krunaldesai/jubilant-waffle/README.md

# jubilant-waffle
HW/SW for PAC-USWHS002-WF-2 replacement based on m5stack AtomS3 mini and ESPhome
