krunaldesai/jubilant-waffle/hw/Carrier_Board/Carrier_Board.kicad_pcb

## KiCad design hw/Carrier_Board/Carrier_Board.kicad_pcb (2025-02-16)

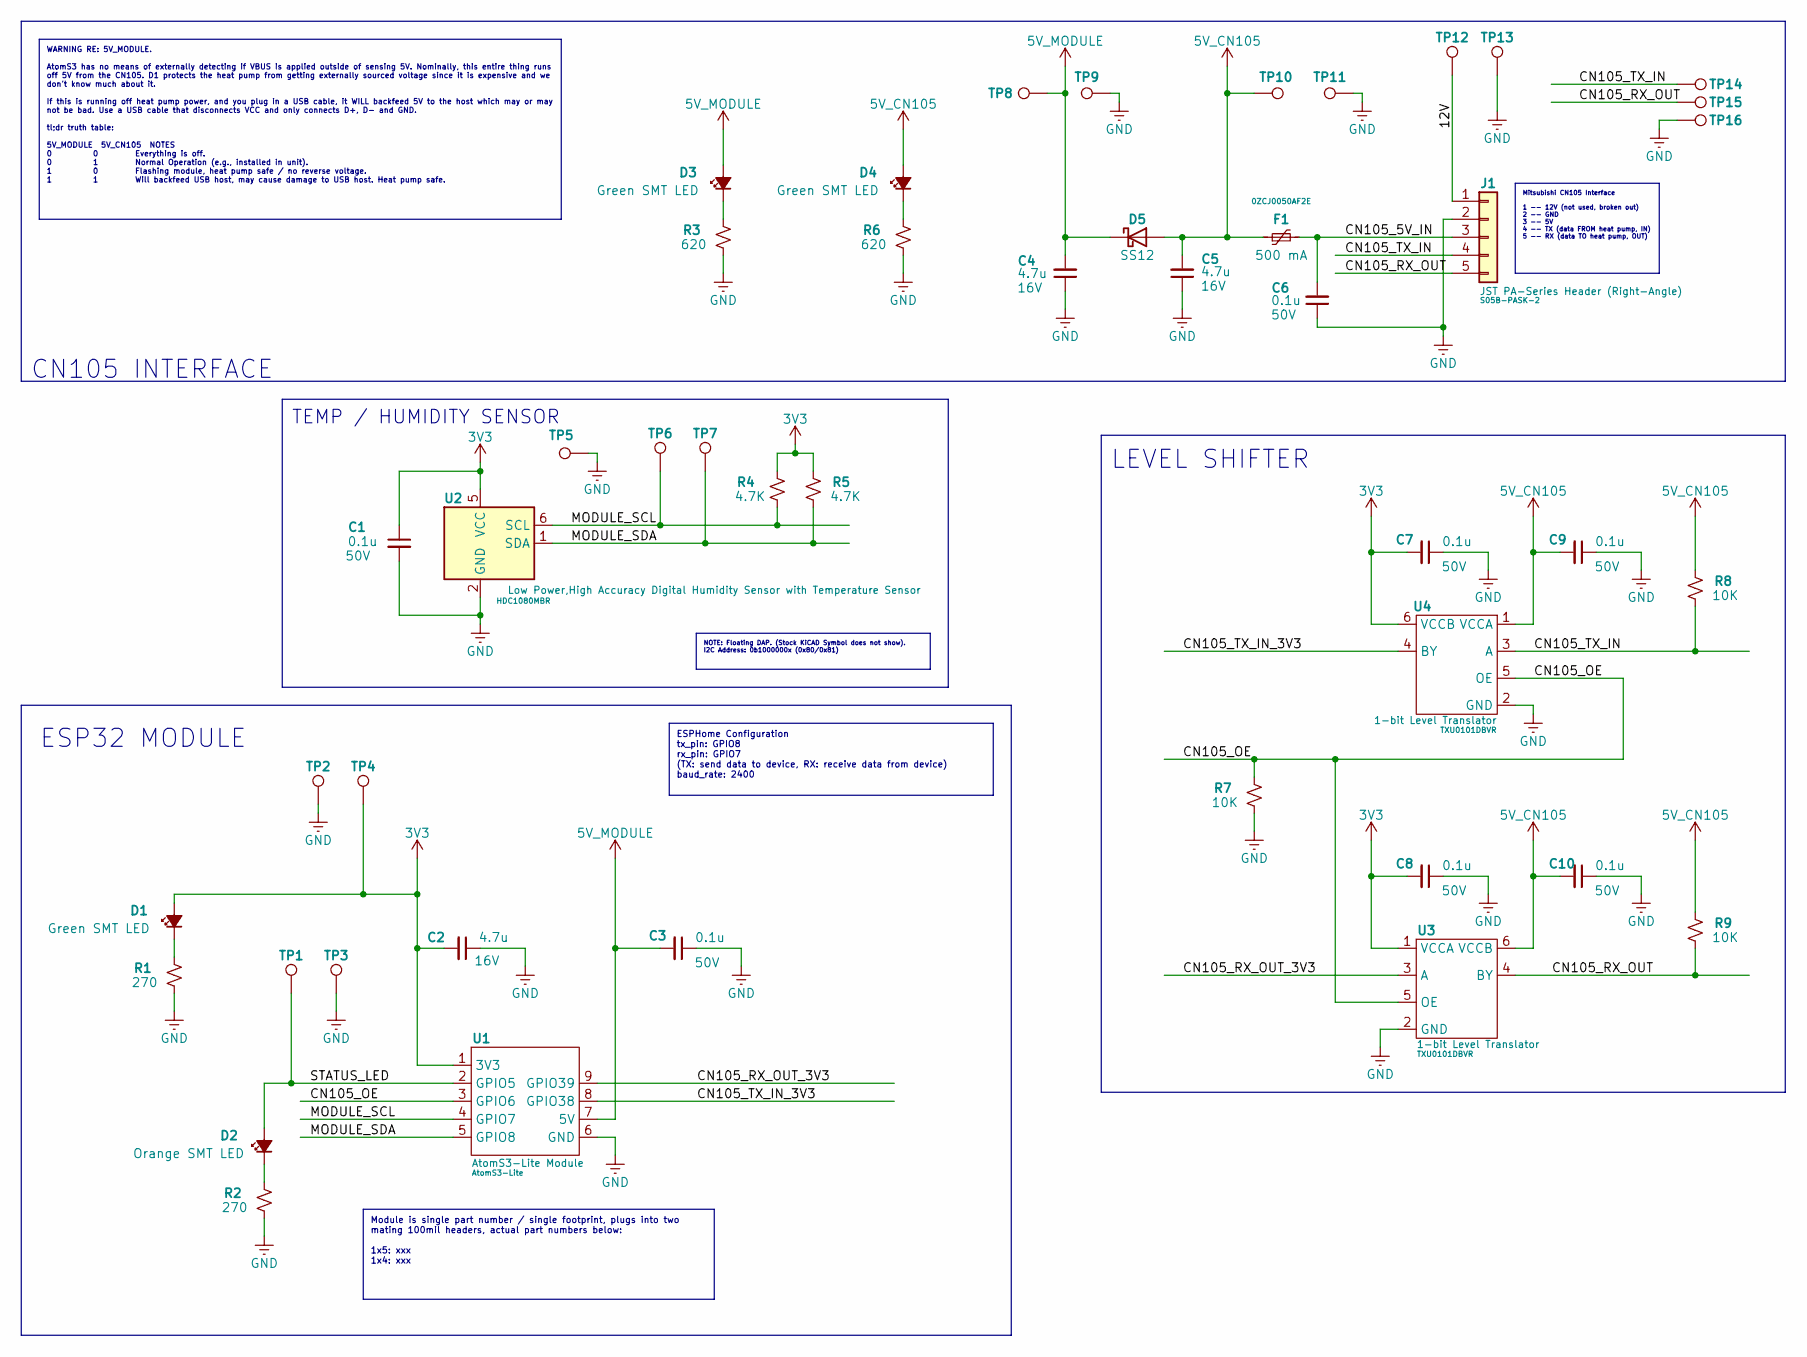
[picture p1: schematic Carrier_Board.kicad_sch, CN105 Interface Board]

Parts:
C1, C3, C6, C7, C8, C9, C10: 0.1u; C_0603_1608Metric_Pad1.08x0.95mm_HandSolder; Voltage 50V; ManufacturerPartNumber C0603C104K5RAC7411
C2, C4, C5: 4.7u; C_0805_2012Metric_Pad1.18x1.45mm_HandSolder; Voltage 16V; ManufacturerPartNumber GRM21BR71C475KE51L
D1, D3, D4: LED_Small_Filled; LED_0603_1608Metric_Pad1.05x0.95mm_HandSolder; ManufacturerPartNumber LTST-C190GKT
D2: LED_Small_Filled; LED_0603_1608Metric_Pad1.05x0.95mm_HandSolder; ManufacturerPartNumber LTST-C190AKT
D5: SS12; D_SMA; ManufacturerPartNumber SS12
F1: 500 mA; Fuse_1206_3216Metric_Pad1.42x1.75mm_HandSolder; ManufacturerPartNumber 0ZCJ0050AF2E
J1: JST PA-Series Header (Right-Angle); JST_PA_S05B; ManufacturerPartNumber S05B-PASK-2
R1, R2: 270; R_0603_1608Metric_Pad0.98x0.95mm_HandSolder; ManufacturerPartNumber ERJ-3GEYJ271V
R3, R6: 620; R_0603_1608Metric_Pad0.98x0.95mm_HandSolder; ManufacturerPartNumber ERJ-3GEYJ621V
R4, R5: 4.7K; R_0603_1608Metric_Pad0.98x0.95mm_HandSolder; ManufacturerPartNumber ERJ-3GEYJ472V
R7, R8, R9: 10K; R_0603_1608Metric_Pad0.98x0.95mm_HandSolder; ManufacturerPartNumber ERJ-3GEYJ103V
TP1, TP2, TP3, TP4, TP5, TP6, TP7, TP8, TP9, TP10, TP11, TP12, TP13, TP14, TP15, TP16: TestPoint; TestPoint_Keystone_5000-5004_Miniature
U1: Atom_S3-Lite; ManufacturerPartNumber AtomS3-Lite
U2: HDC1080; Texas_PWSON-N6; ManufacturerPartNumber HDC1080MBR
U3, U4: SOT-23-6_Handsoldering; ManufacturerPartNumber TXU0101DBVR

Connections:
3V3: C1.1, C2.2, C7.2, C8.2, D1.2 (A), R4.1, R5.1, TP4.1, U1.1 (3V3), U2.5 (VCC), U3.1 (VCCA), U4.6 (VCCB)
5V_CN105: C5.2, C9.2, C10.2, D4.2 (A), D5.2 (A), F1.1, R8.1, R9.1, TP10.1, U3.6 (VCCB), U4.1 (VCCA)
5V_MODULE: C3.2, C4.2, D3.2 (A), D5.1 (K), TP8.1, U1.7 (5V)
/12V: J1.1, TP12.1
/CN105_5V_IN: C6.2, F1.2, J1.3
/CN105_OE: R7.1, U1.3 (GPIO6), U3.5 (OE), U4.5 (OE)
/CN105_RX_OUT: J1.5, R9.2, TP15.1, U3.4 (BY)
/CN105_RX_OUT_3V3: U1.9 (GPIO39), U3.3 (A)
/CN105_TX_IN: J1.4, R8.2, TP14.1, U4.3 (A)
/CN105_TX_IN_3V3: U1.8 (GPIO38), U4.4 (BY)
/MODULE_SCL: R4.2, TP6.1, U1.4 (GPIO7), U2.6 (SCL)
/MODULE_SDA: R5.2, TP7.1, U1.5 (GPIO8), U2.1 (SDA)
/STATUS_LED: D2.2 (A), TP1.1, U1.2 (GPIO5)
GND: C1.2, C2.1, C3.1, C4.1, C5.1, C6.1, C7.1, C8.1, C9.1, C10.1, J1.2, R1.2, R2.2, R3.2, R6.2, R7.2, TP2.1, TP3.1, TP5.1, TP9.1, TP11.1, TP13.1, TP16.1, U1.6 (GND), U2.2 (GND), U3.2 (GND), U4.2 (GND)
unnamed: D1.1 (K), R1.1
unnamed: D2.1 (K), R2.1
unnamed: D3.1 (K), R3.1
unnamed: D4.1 (K), R6.1

Notes on the sheet:
LEVEL SHIFTER
TEMP / HUMIDITY SENSOR
ESP32 MODULE
CN105 INTERFACE
NOTE: Floating DAP. (Stock KiCAD Symbol does not show). I2C Address: 0b1000000x (0x80/0x81)
ESPHome Configuration tx_pin: GPIO8 rx_pin: GPIO7 (TX: send data to device, RX: receive data from device) baud_rate: 2400
Module is single part number / single footprint, plugs into two mating 100mil headers, actual part numbers below: 1x5: xxx 1x4: xxx
WARNING RE: 5V_MODULE. AtomS3 has no means of externally detecting if VBUS is applied outside of sensing 5V. Nominally, this entire thing runs off 5V from the CN105. D1 protects the heat pump from getting externally sourced voltage since it is expensive and we don't know much about it. If this is r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
Mitsubishi CN105 Interface 1 -- 12V (not used, broken out) 2 -- GND 3 -- 5V 4 -- TX (data FROM heat pump, IN) 5 -- RX (data TO heat pump, OUT)

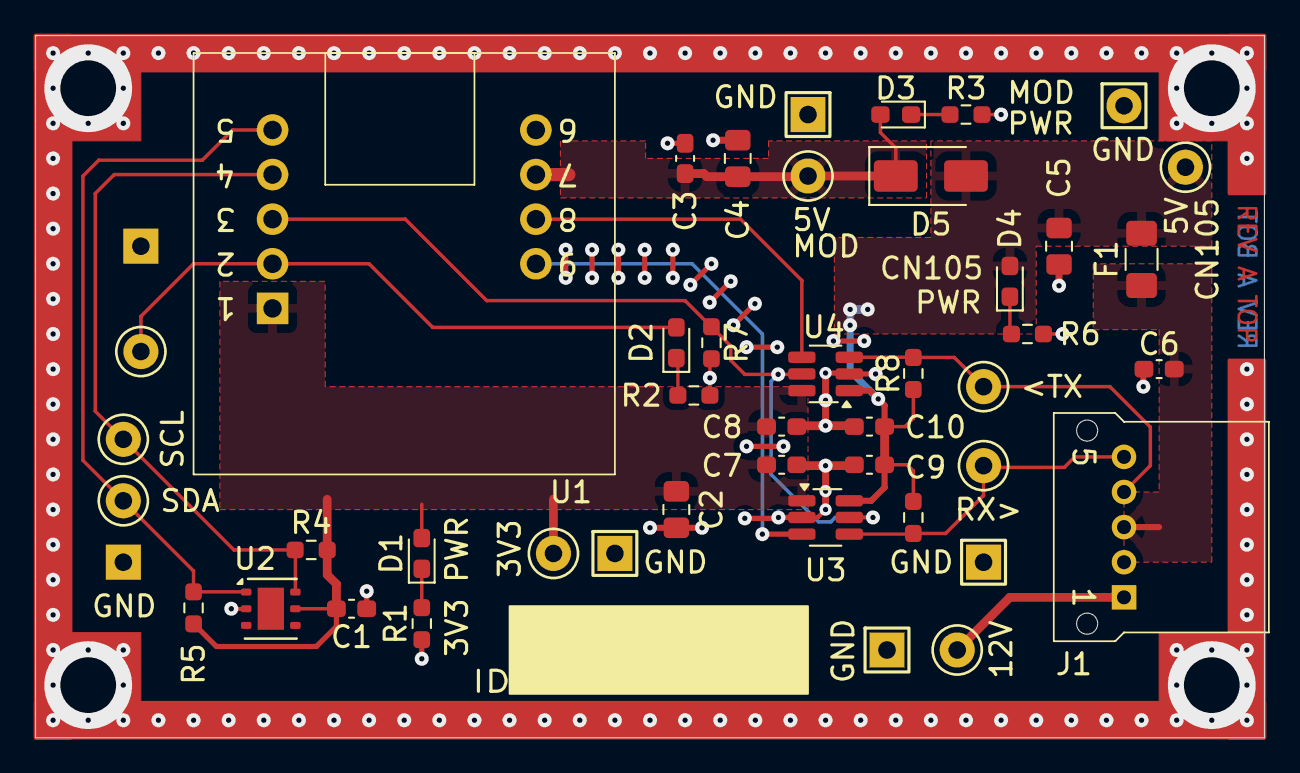
[picture p2: board Carrier_Board.kicad_pcb from above]

Board: 2 copper layers, 70.0 x 40.0 mm, 46 parts (0 on the bottom side), 18 nets.
