krunaldesai/jubilant-waffle/(commit log)

2025-01-23 hw: initial commit of first kicad project messing around
    [Carrier_Board.kicad_pcb, Carrier_Board.kicad_sch]
2025-02-09 hw: initial schematic mostly done, pushing for reference
    [Carrier_Board.kicad_pcb, Carrier_Board.kicad_sch]
2025-02-10 hw: initial layout done as well
    [Carrier_Board.kicad_pcb, Carrier_Board.kicad_sch]
2025-02-10 hw: ready for initial quoting
    [Carrier_Board.kicad_pcb, Carrier_Board.kicad_sch]
2025-02-10 hw: few little tweaks
    [Carrier_Board.kicad_pcb]
2025-02-16 hw: revA for fab
    [Carrier_Board-B_Cu.gbl, Carrier_Board-B_Mask.gbs, Carrier_Board-B_Silkscreen.gbo, Carrier_Board-Edge_Cuts.gm1, Carrier_Board-F_Cu.gtl, Carrier_Board-F_Mask.gts, Carrier_Board-F_Silkscreen.gto, Carrier_Board-NPTH.drl]
